shubhambansal013/3d_models/spotlight_base/base_plate_bottom.png

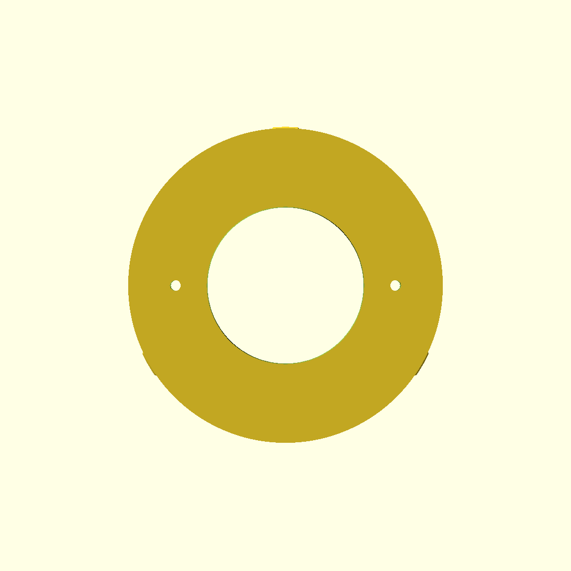
spotlight_base/base_plate_bottom.png
