shubhambansal013/3d_models/spotlight_base/base_plate_side.png

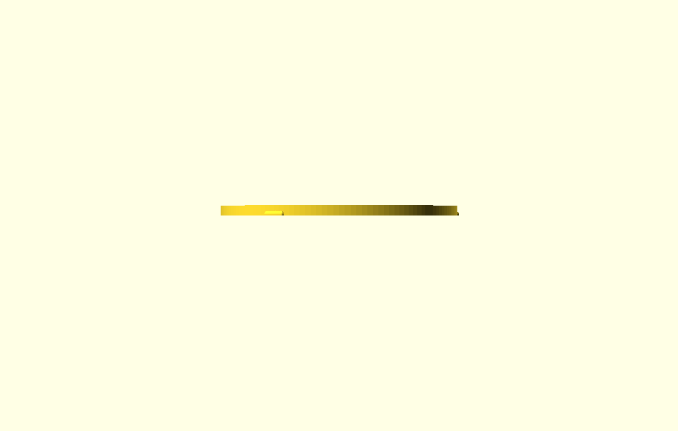
spotlight_base/base_plate_side.png
