shubhambansal013/3d_models/spotlight_base/mount_plate_bottom.png

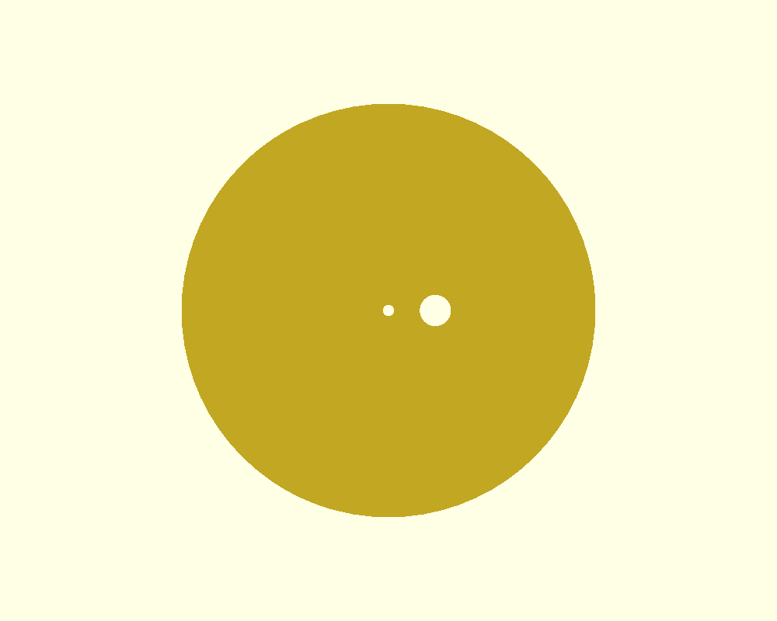
spotlight_base/mount_plate_bottom.png
