shubhambansal013/3d_models/spotlight_base/output/base.step

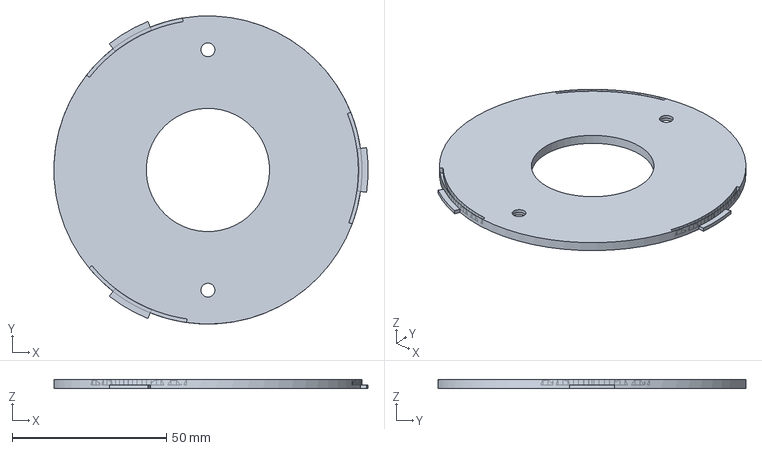
[picture p6: CAD file, 2026-08-04]
spotlight_base/output/base.step
101.9 x 99.9 x 3.00 mm
