shubhambansal013/3d_models/spotlight_base/output/mount.step

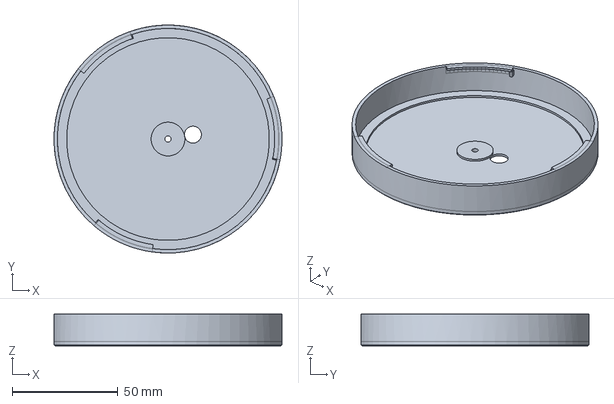
[picture p7: CAD file, 2026-08-04]
spotlight_base/output/mount.step
108.0 x 108.0 x 15.0 mm
