shubhambansal013/3d_models/(list of files, cad)

Other CAD files:
spotlight_base/output/base.stl
spotlight_base/output/mount.stl
