shubhambansal013/3d_models/spotlight_base/assembled_iso.png

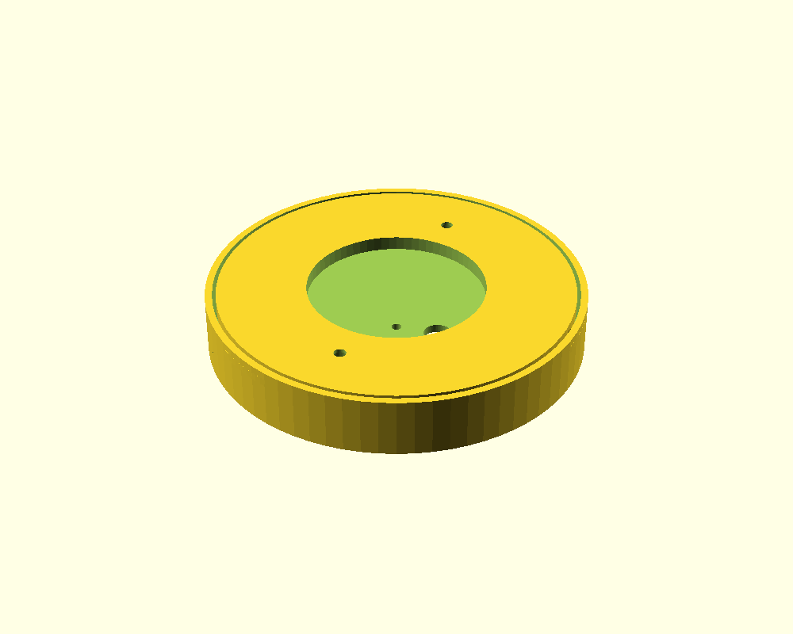
spotlight_base/assembled_iso.png
