shubhambansal013/3d_models/spotlight_base/assembled_top.png

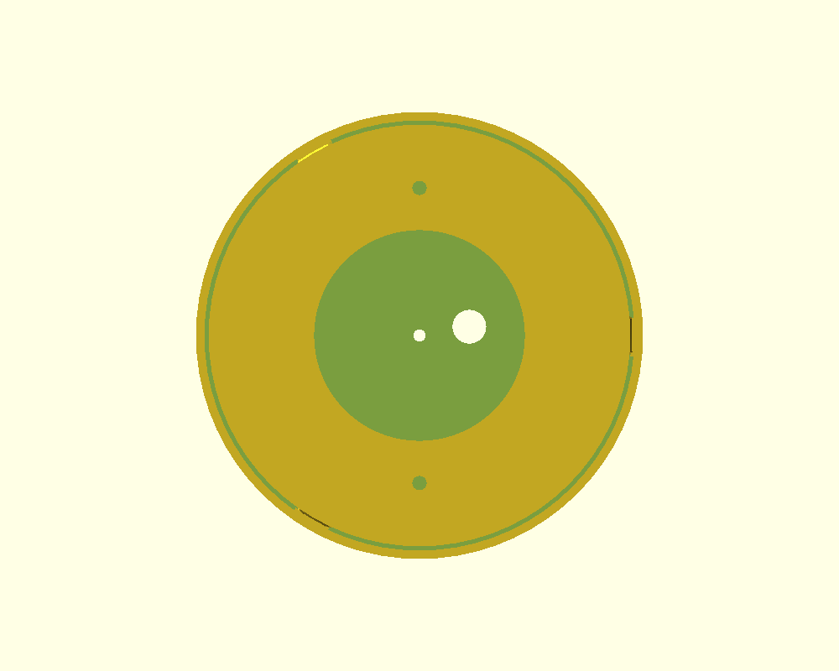
spotlight_base/assembled_top.png
