shubhambansal013/3d_models/(commit log)

2026-07-29 Added spotlight
    [base.scad]
2026-07-31 docs: plan spotlight mount redesign
2026-07-31 phase 1: base plate rebuild (Ø100 annulus + rim tabs)
    - Rewrite base_plate(): Ø100×4 annulus, Ø50 wire hole, 2× flush
    counterbored M3 holes (Ø3.4 through + Ø6.2×3), 3 rim lock tabs.
    - Re-derive rim bend at bend_r=plate_radius+1 (51): tab tip r=50.75
    centered on 0°/120°/240°, base embedded 0.25 into rim (lock_protrusion
    1.0 = 0.75 proud + 0.25 embed).
    - Fix blind-hole bug: wire + screw cutters now span z∈[-1,5].
    - Tab vertical band z∈[0,2] (flush with annulus bottom, prints flat).
    - Add base plate render PNGs (iso/top/bottom/side).
    [base.scad]
2026-07-31 phase 2: mount plate cap rebuild (Ø106 cap + rim twist channels + boss)
    - Replace socket cylinder with Ø106 cap: disc + 14mm skirt reaching the
    ceiling, central Ø9.5 boss with Ø2.9 pilot, Ø8 wire exit at r=12.
    - New direct-geometry rim_channel(): outer wall ring, roof overhang
    (r 50.4, z 1.5) and back-wall slab, threefold at ch_ang_rot=-10.
    Sized from the measured phase-1 tab wedge profile (crest 0.75-1.6,
    angular ±5, outer r 50.75).
    - Remove shaft_radius; keep lock_channel_linear for debugging.
    - Verified by STL intersection sweep vs the real base_plate: free drop
    and 10° twist travel, hard back-wall stop, roof captures pullout at
    seat (blocked after 0.3mm lift), free rel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
    [base.scad]
2026-07-31 phase 3: assembly verification, final renders, docs
    - Verified assembled view: cap skirt top meets ceiling plane (z=6), cap
    (±53) fully hides base (max r 50.75), screw heads clear by 10mm, wire
    path (ceiling -> Ø50 base hole -> cavity -> Ø8 exit) unobstructed.
    - diff_check at seat is empty by design (no interference); blank PNG is
    the honest artifact.
    - Added renders: assembled_iso/top/bottom, mount_plate_iso/top/bottom
    (phase-2 render set, byte-identical to re-render), diff_check. base_plate
    renders unchanged from phase 1.
    - Recorded final STL dims (analyze_model): base Ø100x4, cap Ø106 z[-5,16.5],
    assembled z[-15.5,6].
    - Cleanup: removed dead params tolerance + assembly_ga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
    [base.scad]
2026-07-31 docs: plan material optimization
2026-07-31 phase 1: base plate ring pocket (base 23.4→17.5 cm³, −25%)
    [base.scad]
2026-08-01 phase 2: mount plate lip fillet (subtractive quarter-round, −0.9 cm³)
    [base.scad]
2026-08-01 Added cadquery design of spotlight and restructured the repo.
    [base.scad]
2026-08-02 Enhanced the spotlight mount.
    1. Fixed errors of lock tab size.
    2. Reduced filament usage.
    3. Added stl outputs.
    [base.step, base.stl]
2026-08-02 Reduced print volume by reduce plate height.
    [base.stl]
2026-08-02 Separated base and mount stls
    [base.stl]
2026-08-02 Added mount stls.
    [mount.step, mount.stl]
2026-08-02 Reverted base plate size
2026-08-02 docs: plan spotlight mount v2 (compact, beefed twist-lock)
2026-08-02 Removed obsolete scad files
    [base.scad]
2026-08-02 docs: prune completed plans, add spotlight_base README
    - Add spotlight_base/README.md: design, key decisions, derived lock radii,
    measured fit (OCC kernel), verification tiers, OCP gotchas, layout.
    - Delete completed plans: material-optimization, spotlight-mount-redesign,
    verification-fix, verification-handoff.md, verification-test-plan.md
    (facts distilled into the README; only pending spotlight-mount-v2 remains).
    - Repoint AGENTS.md + conftest.py + v2 phase docs at the README.
2026-08-02 feat: phase-1 base rebuild — Ø100 monolithic lugs
    Replace slice-built cylindric_bend tabs with monolithic revolve lugs on a
    compact Ø100×3 base: lock_lug() (full-height rib → 1.2 mm stepped lip, 0.8 mm
    root fillet on the fused junction edges), base_plate() now fuses to a single
    solid. Params rewritten (plate/lug/screw/wire/pocket); dead helpers removed
    (cylindric_bend, lock_tab, lock_tab_linear, lip_prism, hull_solid,
    lock_channel_linear). ch_* derived radii now keyed off lug_tip_r for phase 2.
2026-08-02 docs: phase-1 done — mark PLAN done, update NOTES
    Phase 1 (base rebuild) complete: 14.62 cm³ single fused solid. NOTES current-state
    now points at phase 2 (cap rebuild); deviations logged (lug_overlap 0.5 for a true
    boolean union, post-fuse root fillet, ch_* keyed off lug_tip_r).
2026-08-02 feat: spotlight-mount-v2 complete — Ø100/Ø108, 25 tests green, 40.5 g
    Phases 3–8 executed: cache rebuild, integration tests (seat/rotation/
    pullout/tilt), strength model, full suite + exports, docs.
    - roof_capture 0.6→0.5 for classifier-clear roof/root boundary
    - conftest grid() handles n_z=1; lug_points fixture replaces tab_points
    - test_tilt.py: new ±0.5/+0.3 mm assembly-shift probes
    - test_pullout.py: targeted lip grid for roof-catch assertion
    - test_strength.py: uses lug_width/lug_tip_r/lug_step_r; FoS≥5
    - AGENTS.md + README.md updated to v2 geometry and measured goldens
    - 25 passed in 4.4 s; total 32.66 cm³ / 40.5 g (−64.3% volume)
    - Plan folder removed; must-keep facts d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
    [base.stl, mount.step, mount.stl]
2026-08-03 Widened the lug back
    [base.step, mount.step, mount.stl]
2026-08-03 fix: mount fuses to one solid + 0.4mm chamfer (print time 6h -> ~1.5h)
    Root cause of the 6h slice: the mount exported as 4 touching solids with a
    double-walled seam at r=52.2 (3 non-manifold edges), so the slicer filled the
    O104 skirt cavity with solid infill. ch_bury=0.15 now buries the channel roof
    and back-wall slab into the wall ring so mount_plate() fuses into ONE solid;
    slicer detects the cavity and solid infill collapses.
    Also: replace the 2mm bottom lip fillet with a 0.4mm chamfer (the fillet
    flare around the full O108 perimeter forced supports). Align test_rotation to
    the widened back-wall onset (free through rot 11, blocked at rot 12); update
    README/AGENTS golden numbers (mount =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
    [mount.step, mount.stl]
2026-08-03 feat: 3mm lock grip — shelf lugs + plate top-rim relief
    Roof now overhangs 3mm past the lug tip and grips the full 3mm-wide
    shelf lip (r 49-52) on pullout. Lugs become low shelves (no upper rib);
    the plate's ceiling-side rim is relieved over the three channel arcs so
    the roof seats and travels. Drops the 0.8mm root fillet. Keeps the
    user's O2.9 pilot through the disc. 27 tests green (base 14.27 cm3,
    mount 19.15 cm3).
    [base.step, base.stl, mount.step, mount.stl]
2026-08-03 fix: open twist-lock sliding clearance 0.2 -> 0.4 mm (ch_clear)
    The lug tip rides the channel outer wall through the whole drop->seat twist;
    0.2 mm was press/snap and FDM drift bound all three lugs on attach and
    detach. 0.4 mm is the sliding-twist range. Lock grip (3 mm roof capture)
    unchanged. Rebuild cache, refresh output exports (tolerance 0.01), fix
    export kwargs so base.py runs standalone.
    [base.step, base.stl, mount.step, mount.stl]
2026-08-03 fix: free detach — roof_capture 3 -> 1.5 mm (roof outside plate radius)
    The 3 mm grip reached ch_roof_in = 49, inside plate_radius 50: the roof was
    permanently embedded in the plate rim, so the mount could never detach
    (base-mount intersection never reached zero at any rotation). Decouple
    lug_step_r (49) from roof_capture and set roof_capture = 1.5 so the roof
    sits at r 50.5, outside the plate. Detach is now a force-free reverse twist
    to rot ~ -21 then straight pull (probed collision-free to z_off -3.5); the
    drop pose still binds by design (1.5 mm lock grip). 38 tests green.
    [base.step, mount.step, mount.stl]
2026-08-04 Final step and stls
    [base.step, mount.step, mount.stl]
